mattsm18/powder_drum_FW/README.md

# powder_drum_FW

Firmware for ENME891 - Industrial Project

# About

ENME891 is the capstone paper for the BE(Hons) degree at AUT. It is a year-long industrial project where students develop a real-world engineering solution.

### Project name: 
<b>Quanitfying the flowability of milk powders through the use of computer vision </b>

### Project members / responsibilities:
- Matthew Smith -> Embedded Firmware and Software Development, Mechanical Design, Electronic Design & Assembly
- Josh Russell -> Mechanical build and machining, MATLAB Computer vision modelling.

# Target
### Arduino Nano Every 
Potential for future, more capable targets due to using the PlatformIO framework

# Functionality
- Drive stepper motor from 0.1-70RPM with a closed-loop PID controller
- Control a 5V Relay Module
- Run bi-directional comms over serial to [powder_drum_SW](https://github.com/mattsm18/powder_drum_SW)

# Libraries

### StepperMotor
- Handles pin assignment, microstepping and internal velocity tracking
- Attaches a tick function to an ISR for atomic stepping

### AS5600 (Magnetic Encoder)
- Handles pin assignment and I2C comms with the encoder
- Determines current angular velocity of the motor
- Applies a 1st order discrete time filter

### PIDController
- Wraps all PID Controller functionality
- Handles dynamic Kp, Ki and Kd gains

### SerialManager
- Implements the packet framing protocol (SOF, header, payload, XOR CRC) over serial
- Validates and dispatches incoming GET/SET requests, returning ACK/NACK per the protocol

### PowderDrumProtocol
- Auto-generated from a single JSON source of truth (config/pd_comms_protocol_vX.X.json)
- Provides parameter metadata lookup (existence, access permissions) used by SerialManager

# Dependencies
- Use of the PlatformIO extension in VSCode for compiling, running and debugging code

# System Diagram
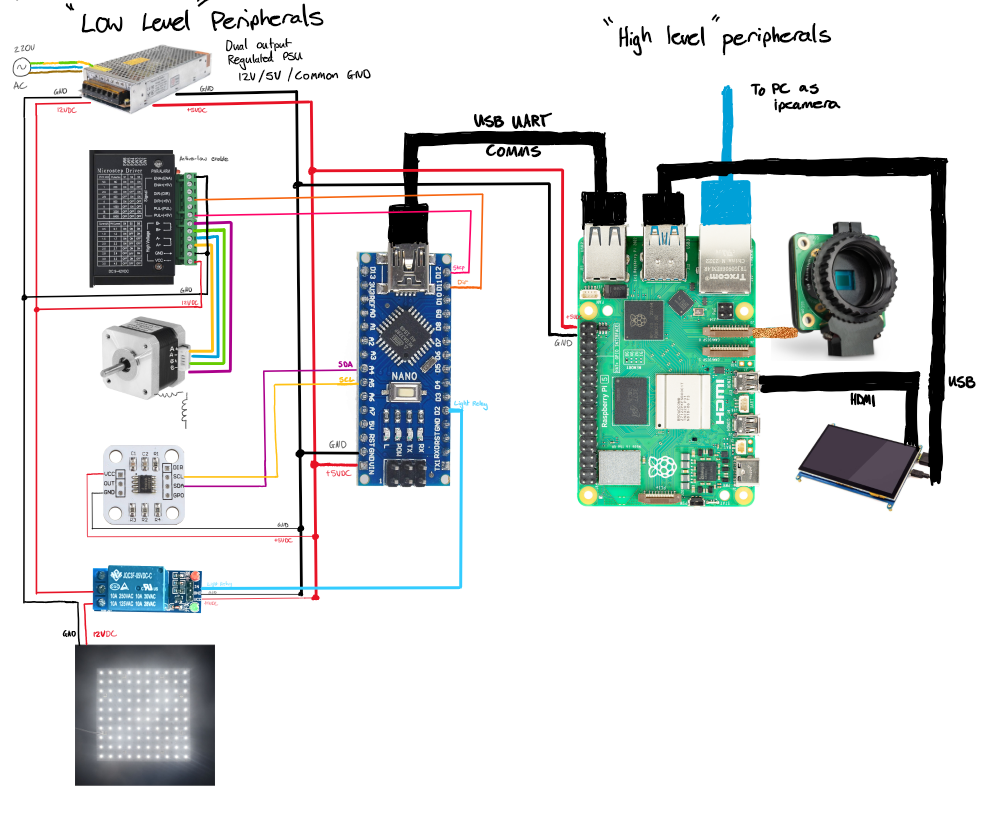
[picture p1: docs/system_diagram.png]
System


# Serial Comms Protocol
The powder drum implements a custom bi-directional serial comms protocol in 
the firmware and the software

This protocol includes ACKs, NACKs and a XOR CRC checksum to validate data integrity on the wire.

Fully implemented in the firmware, some work still to do for ACK and NACK handling in the software.
