mattsm18/powder_drum_FW/pcb/powder_drum.kicad_pcb

## KiCad design pcb/powder_drum.kicad_pcb (2026-07-24, last stored version)

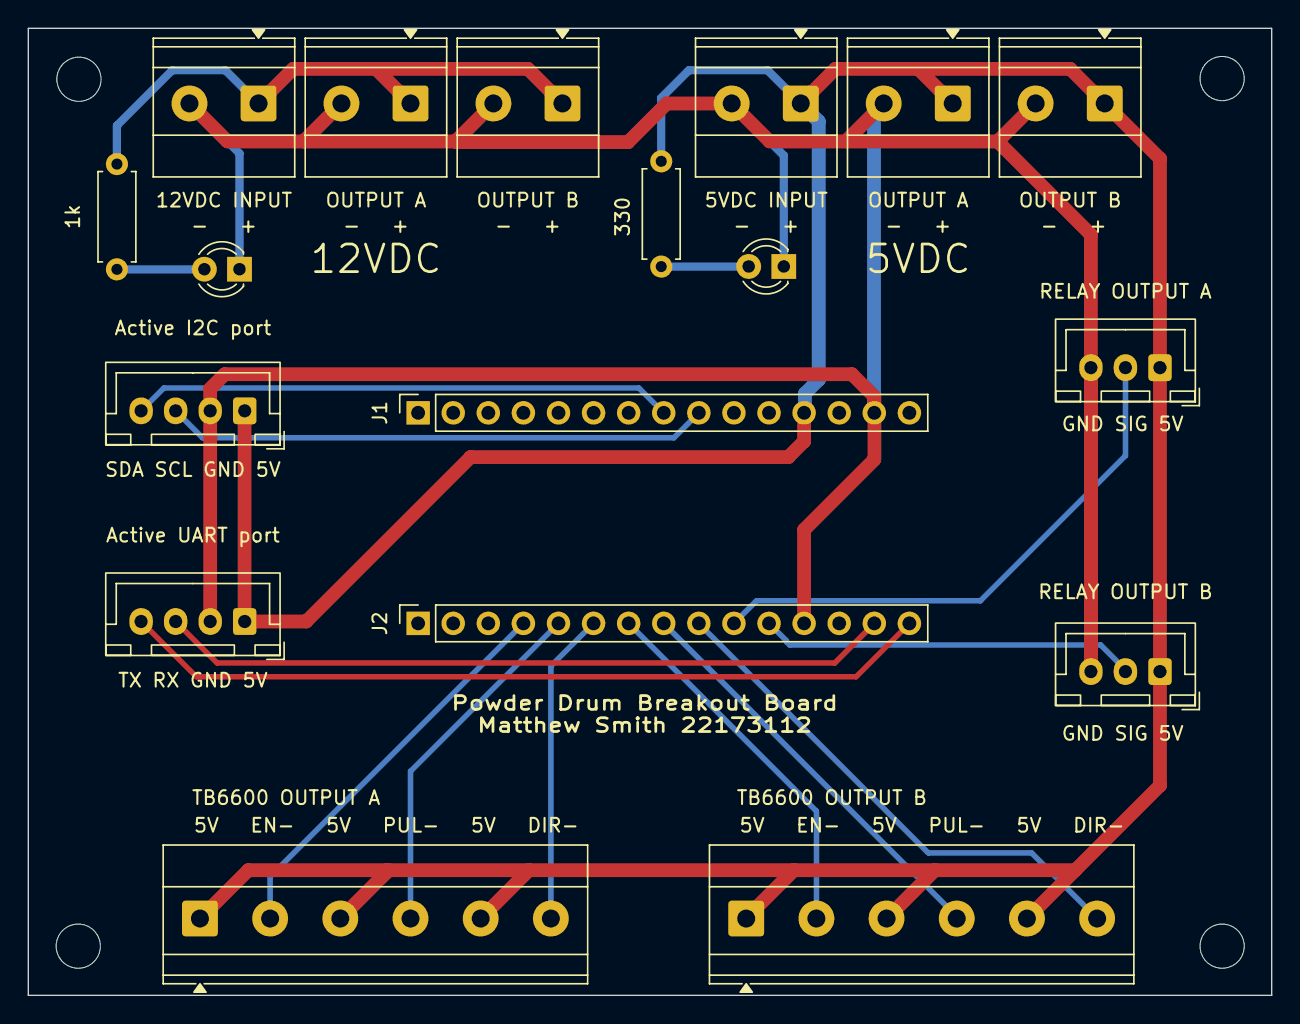
[picture p2: board powder_drum.kicad_pcb from above]

Board: 2 copper layers, 90.0 x 70.0 mm, 18 parts (0 on the bottom side), 18 nets.

Parts:
D1, D2: LED; LED_D3.0mm
J1: Analog; PinSocket_1x15_P2.54mm_Vertical
J2: Digital; PinSocket_1x15_P2.54mm_Vertical
J3: 12VDC INPUT; TerminalBlock_Phoenix_MKDS-1,5-2_1x02_P5.00mm_Horizontal
J4: 5VDC INPUT; TerminalBlock_Phoenix_MKDS-1,5-2_1x02_P5.00mm_Horizontal
J5: TB6600 OUTPUT A; TerminalBlock_Phoenix_MKDS-1,5-6-5.08_1x06_P5.08mm_Horizont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
J6: TB6600 OUTPUT B; TerminalBlock_Phoenix_MKDS-1,5-6-5.08_1x06_P5.08mm_Horizont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
J7: Active UART port; JST_XH_B4B-XH-A_1x04_P2.50mm_Vertical
J8: RELAY OUTPUT B; JST_XH_B3B-XH-A_1x03_P2.50mm_Vertical
J9: RELAY OUTPUT A; JST_XH_B3B-XH-A_1x03_P2.50mm_Vertical
J10, J12: OUTPUT A; TerminalBlock_Phoenix_MKDS-1,5-2_1x02_P5.00mm_Horizontal
J11, J13: OUTPUT B; TerminalBlock_Phoenix_MKDS-1,5-2_1x02_P5.00mm_Horizontal
J14: Active I2C port; JST_XH_B4B-XH-A_1x04_P2.50mm_Vertical
R1: 330; R_Axial_DIN0207_L6.3mm_D2.5mm_P7.62mm_Horizontal
R2: 1k; R_Axial_DIN0207_L6.3mm_D2.5mm_P7.62mm_Horizontal

Connections:
+5V: J1.12, J4.1, J5.1, J5.3, J5.5, J6.1, J6.3, J6.5, J7.1, J8.1, J9.1, J12.1, J13.1, J14.1, R1.1
+12V: J3.1, J10.1, J11.1, R2.1
/*D3/RELAY A: J2.10, J9.2
/*D5/B PUL-: J2.8, J6.4
/*D6/B ENA-: J2.7, J6.2
/*D9/A ENA-: J2.4, J5.2
/A4/SDA: J1.8, J14.4
/A5/SCL: J1.9, J14.3
/D0/RX: J2.14, J7.3
/D1/TX: J2.15, J7.4
/D2/RELAY B: J2.11, J8.2
/D4/B DIR-: J2.9, J6.6
/D7/A DIR-: J2.6, J5.6
/D8/A PUL-: J2.5, J5.4
/~RESET: J1.13, J2.13
GND: D1.1 (K), D2.1 (K), J1.14, J2.12, J3.2, J4.2, J7.2, J8.3, J9.3, J10.2, J11.2, J12.2, J13.2, J14.2
unnamed: D1.2 (A), R1.2
unnamed: D2.2 (A), R2.2
