mattsm18/powder_drum_FW/include/pins.h

#ifndef PINS_H
#define PINS_H

/*
Title: pins.h
Author: Matthew Smith
Date: 29/04/26
Purpose:
-   Name pin definitions for the given chip target - in this case an arduino nano every.

*/

// TB6600 A
#define TB6600_DRIVER_A_ENA 9
#define TB6600_DRIVER_A_PUL 8
#define TB6600_DRIVER_A_DIR 7

// TB6600 B
#define TB6600_DRIVER_B_ENA 6
#define TB6600_DRIVER_B_PUL 5
#define TB6600_DRIVER_B_DIR 4

// Relay Outputs
#define RELAY_OUTPUT_A 3
#define RELAY_OUTPUT_B 2

#endif
