mattsm18/powder_drum_FW/(commit log)

2026-04-30 Functioning, accurate open-loop stepper motor class implementation - More work needed on AS5600
2026-05-01 Encoder Angular Velocity with EMA filter, decent angular velocity estimation, slightly lagging reality
2026-05-06 fixed encoder bug with negative value
    [main.cpp]
2026-06-08 Time const for encoder filter changed
2026-07-24 New Universal Stepper Class - Better modularity
    [bom.csv, designators.csv, positions.csv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]
2026-07-28 Renamed variables in stepper class to be more intuitive
2026-07-29 Stop tracking PCB (HW) in FW repo
    now located at https://github.com/mattsm18/powder_drum_HW
    [bom.csv, designators.csv, positions.csv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]
2026-07-29 Removed old motor slider test program
2026-08-03 Codebase is ready to optimise encoder read time and tune PID
2026-08-03 Clean up AS5600 velocity estimation for better accuracy with lower noise floor
    [MotionManager.cpp, MotionManager.h, main.cpp, serial_test_tool.py]
2026-08-10 Updated sign convention + PID gains
2026-08-28 Working version open loop - found bug where encoder i2c read blocks the serial comms
    [MotionManager.cpp, MotionManager.h, SerialManager.cpp, main.cpp, serial_test_tool_scalable.py]
2026-10-19 Reading Encoder with AsyncTWI
2026-10-19 Fixed stall issue
2026-10-19 Good angular displacement reading, bad velocity estimates
